Maillouski/M2-IO-Emulator-Board/fabrication/jlcpcb/m2-io-emulator-board-BOM-jlcpcb.csv

Comment | Designator | Footprint | LCSC Part #
100nF 50V X7R 0805 | C1,C2,C3,C4,C5,C6,C7,C8,C9,C10,C11,C12,C13,C14,C15,C16,C18,C20,C21,C22,C24,C27,C28,C29,C31,C33,C35,C36,C38,C43,C44,C46 | C_0805_2012Metric | C49678
10uF 25V X5R 0805 | C19,C23,C25,C26,C30,C32,C34,C37,C41,C42,C45 | C_0805_2012Metric | C15850
10nF 50V X7R 0805 | C39,C40 | C_0805_2012Metric | C1710
22uF 25V X5R 0805 | C47,C48 | C_0805_2012Metric | C45783
600R@100MHz 0805 | FB1 | L_0805_2012Metric | C1017
10029449-111RLF | J15 | HDMI_A_Amphenol_10029449-x01xLF_Horizontal | C427307
4.7k 1% 0805 | R1,R2,R3,R4,R5,R6,R7,R8,R9,R10,R11,R12,R13 | R_0805_2012Metric | C17673
1k 1% 0805 | R14,R15,R16,R17,R18,R19,R20,R21,R22,R23,R24,R25,R26,R27,R28,R29,R30,R31,R32,R33,R34,R35,R36,R37,R46,R60 | R_0805_2012Metric | C17513
10k 1% 0805 | R38,R39,R40,R41,R42,R43,R44,R45,R61,R62,R63,R64,R65 | R_0805_2012Metric | C17414
470R 1% 0805 | R47 | R_0805_2012Metric | C17710
75R 1% 0805 | R48,R49,R50 | R_0805_2012Metric | C141697
604R 1% 0805 | R51,R52,R53 | R_0805_2012Metric | C228933
200R 1% 0805 | R54,R55,R56 | R_0805_2012Metric | C17540
33R 1% 0805 | R57,R58,R59 | R_0805_2012Metric | C17634
2.2k 1% 0805 | R66,R67 | R_0805_2012Metric | C17520
74HCT86D | U2 | SOIC-14_3.9x8.7mm_P1.27mm | C6005
OPA3355EA | U3 | TSSOP-14_4.4x5mm_P0.65mm | C2652730
AT24C02C-SSHM-T | U6 | SOIC-8_3.9x4.9mm_P1.27mm | C6203
TS5V330CPWR | U7 | TSSOP-16_4.4x5mm_P0.65mm | C2652470
SN74HCT157DR | U8 | SOIC-16_3.9x9.9mm_P1.27mm | C6771
