Maillouski/M2-IO-Emulator-Board/bom/BOM-digikey.csv

Quantity | Digi-Key Part Number | Manufacturer Part Number | Manufacturer | Customer Reference
32 | 311-1140-1-ND | CC0805KRX7R9BB104 | YAGEO | C1-C16, C18, C20-C22, C24, C27-C29, C31, C33, C35, C36, C38, C43, C44, C46
11 | 1276-2891-1-ND | CL21A106KAYNNNE | Samsung Electro-Mechanics | C19, C23, C25, C26, C30, C32, C34, C37, C41, C42, C45
2 | 311-1136-1-ND | CC0805KRX7R9BB103 | YAGEO | C39, C40
2 | 1276-6780-1-ND | CL21A226MOCLRNC | Samsung Electro-Mechanics | C47, C48
1 | P19632CT-ND | EEU-FC1C101H | Panasonic Industry | C17
1 | 754-1603-ND | WP710A10GD | Kingbright | D1
1 | 490-BLM21PG601SN1DCT-ND | BLM21PG601SN1D | Murata Electronics | FB1
1 | MHC50K-ND | N2550-6002-RB | 3M | J1 (CN1)
1 | MHC26K-ND | N2526-6002-RB | 3M | J2 (CN2)
1 | 455-B10P-SHF-1AA-ND | B10P-SHF-1AA | JST Sales America | J3 (CN3)
2 | 455-B12P-SHF-1AA-ND | B12P-SHF-1AA | JST Sales America | J4 (CN5), J5 (CN6)
5 | 732-5321-ND | 61300811121 | Würth Elektronik | J6-J10
1 | 732-2670-ND | 61301011121 | Würth Elektronik | J11
1 | 732-5309-ND | 61303621121 | Würth Elektronik | J12
1 | L77HDE15SD1CH4F-ND | L77HDE15SD1CH4F | Amphenol ICC | J13
1 | 455-B5P-SHF-1AA-ND | B5P-SHF-1AA | JST Sales America | J14
1 | 609-1010-1-ND | 10029449-001RLF | Amphenol ICC (FCI) | J15
1 | CP-1435-ND | RCJ-2223 | Same Sky | J16
5 | 732-5316-ND | 61300311121 | Würth Elektronik | JP1, JP2-JP4, JP10
5 | 732-5315-ND | 61300211121 | Würth Elektronik | JP5-JP9
10 | A26228-ND | 382811-8 | TE Connectivity | SH1-SH10
13 | 311-4.70KCRCT-ND | RC0805FR-074K7L | YAGEO | R1-R13
26 | 311-1.00KCRCT-ND | RC0805FR-071KL | YAGEO | R14-R37, R46, R60
13 | 311-10.0KCRCT-ND | RC0805FR-0710KL | YAGEO | R38-R45, R61-R65
1 | RMCF0805FT470RCT-ND | RMCF0805FT470R | Stackpole Electronics Inc | R47
3 | 311-75.0CRCT-ND | RC0805FR-0775RL | YAGEO | R48-R50
3 | 311-604CRCT-ND | RC0805FR-07604RL | YAGEO | R51-R53
3 | 311-200CRCT-ND | RC0805FR-07200RL | YAGEO | R54-R56
3 | 311-33.0CRCT-ND | RC0805FR-0733RL | YAGEO | R57-R59
2 | 311-2.20KCRCT-ND | RC0805FR-072K2L | YAGEO | R66, R67
2 | 450-1650-ND | 1825910-6 | TE Connectivity | SW1, SW2
4 | 36-5002-ND | 5002 | Keystone Electronics | TP1-TP4
1 | 497-2356-5-ND | ULN2803A | STMicroelectronics | U1
1 | 1727-6360-1-ND | 74HCT86D,653 | Nexperia | U2
1 | 296-29279-1-ND | OPA3355EA/2K5 | Texas Instruments | U3
1 | AT24C02C-SSHM-TCT-ND | AT24C02C-SSHM-T | Microchip Technology | U6
1 | 296-27548-1-ND | TS5V330CPWR | Texas Instruments | U7
1 | 296-31835-1-ND | SN74HCT157DR | Texas Instruments | U8
1 | 1050-1018-ND | A000067 | Arduino | Arduino Mega 2560 Rev3 (plugs into J6-J12)
