Maillouski/M2-IO-Emulator-Board/kicad/3d/RCJ-2223_generique.step

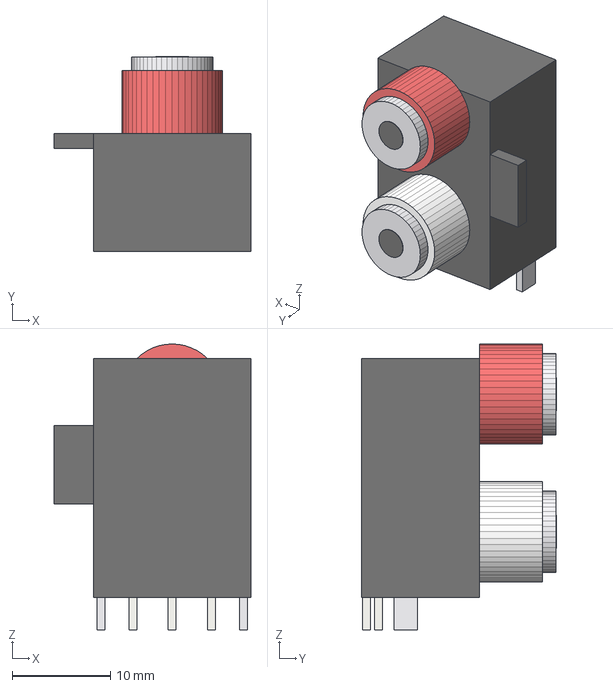
[picture p6: CAD file, 2026-10-16]
kicad/3d/RCJ-2223_generique.step
20.0 x 19.9 x 29.1 mm
