Maillouski/M2-IO-Emulator-Board/kicad/m2-io-emulator-board.kicad_pcb

## KiCad design kicad/m2-io-emulator-board.kicad_pcb (2026-10-17)

Schematic: m2-io-emulator-board.kicad_sch

Parts:
C1, C2, C3, C4, C5, C6, C7, C8, C9, C10, C11, C12, C13, C14, C15, C16, C18, C20, C21, C22, C24, C27, C28, C29, C31, C33, C35, C36, C38, C43, C44, C46: 100 nF; C_0805_2012Metric; MPN CC0805KRX7R9BB104
C17: 100 µF 16 V; CP_Radial_D6.3mm_P2.50mm; MPN EEU-FC1C101H
C19, C23, C25, C26, C30, C32, C34, C37, C41, C42, C45: 10 µF; C_0805_2012Metric; MPN CL21A106KAYNNNE
C39, C40: 10 nF; C_0805_2012Metric; MPN CC0805KRX7R9BB103
C47, C48: 22 µF; C_0805_2012Metric; MPN CL21A226MOCLRNC
D1: LED verte 3 mm; LED_D3.0mm; MPN_CMS_Flux LTST-C170KGKT
FB1: 600 Ω @ 100 MHz; L_0805_2012Metric; MPN GZ2012D601TF
J1: N2550-6002-RB; IDC-Header_2x25_P2.54mm_Vertical; MPN N2550-6002-RB
J2: N2526-6002-RB; IDC-Header_2x13_P2.54mm_Vertical; MPN N2526-6002-RB
J3: B10P-SHF-1AA; JST_NH_B10P-SHF-1AA_1x10_P2.50mm_Vertical; MPN B10P-SHF-1AA
J4, J5: B12P-SHF-1AA; JST_NH_B12P-SHF-1AA_1x12_P2.50mm_Vertical; MPN B12P-SHF-1AA
J6, J7, J8, J9, J10: 61300811121; PinHeader_1x08_P2.54mm_Vertical; MPN 61300811121
J11: 61301011121; PinHeader_1x10_P2.54mm_Vertical; MPN 61301011121
J12: Pin Header 02x18 2.54mm Vertical; PinHeader_2x18_P2.54mm_Vertical; MPN Pin Header 02x18 2.54mm Vertical
J13: VGA femelle; DSUB-15-HD_Socket_Horizontal_P2.29x2.54mm_EdgePinOffset8.35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; MPN L77HDE15SD1CH4F
J14: VIDEO; JST_NH_B5P-SHF-1AA_1x05_P2.50mm_Vertical; MPN B5P-SHF-1AA
J15: HDMI A; HDMI_A_Amphenol_10029449-x01xLF_Horizontal; MPN 10029449-111RLF
J16: XDJK-0271-1650; RCA_Dual_Stacked_RCJ-22xx_XDJK-0271-1650; MPN XDJK-0271-1650
JP1, JP2, JP3, JP4, JP10: 61300311121; PinHeader_1x03_P2.54mm_Vertical; MPN 61300311121
JP5, JP6, JP7, JP8, JP9: 61300211121; PinHeader_1x02_P2.54mm_Vertical; MPN 61300211121
R1, R2, R3, R4, R5, R6, R7, R8, R9, R10, R11, R12, R13: 4,7 kΩ; R_0805_2012Metric; MPN RC0805FR-074K7L
R14, R15, R16, R17, R18, R19, R20, R21, R22, R23, R24, R25, R26, R27, R28, R29, R30, R31, R32, R33, R34, R35, R36, R37, R46, R60: 1 kΩ; R_0805_2012Metric; MPN RC0805FR-071KL
R38, R39, R40, R41, R42, R43, R44, R45, R61, R62, R63, R64, R65: 10 kΩ; R_0805_2012Metric; MPN RC0805FR-0710KL
R47: 470 Ω; R_0805_2012Metric; MPN RMCF0805FT470R
R48, R49, R50: 75 Ω; R_0805_2012Metric; MPN RC0805FR-0775RL
R51, R52, R53: 604 Ω; R_0805_2012Metric; MPN RC0805FR-07604RL
R54, R55, R56: 200 Ω; R_0805_2012Metric; MPN RC0805FR-07200RL
R57, R58, R59: 33 Ω; R_0805_2012Metric; MPN RC0805FR-0733RL
R66, R67: 2,2 kΩ; R_0805_2012Metric; MPN RC0805FR-072K2L
SH1, SH2, SH3, SH4, SH5, SH6, SH7, SH8, SH9, SH10: 382811-8; MPN 382811-8
SW1: TEST; SW_PUSH_6mm; MPN 1825910-6
SW2: SERVICE; SW_PUSH_6mm; MPN 1825910-6
TP1, TP2, TP3, TP4: 5002; TestPoint_Keystone_5000-5004_Miniature; MPN 5002
U1: ULN2803A; DIP-18_W7.62mm; MPN ULN2803A
U2: 74HCT86; SOIC-14_3.9x8.7mm_P1.27mm; MPN 74HCT86D,653
U3: OPA3355EA; TSSOP-14_4.4x5mm_P0.65mm; MPN OPA3355EA/2K5
U4: CS5213; QFN-32-1EP_4x4mm_P0.4mm_EP2.65x2.65mm; MPN CS5213AN
U5: NX3303X; QFN-32-1EP_5x5mm_P0.5mm_EP3.1x3.1mm; MPN NX3303X; not fitted
U6: AT24C02; SOIC-8_3.9x4.9mm_P1.27mm; MPN AT24C02C-SSHM-T
U7: TS5V330; TSSOP-16_4.4x5mm_P0.65mm; MPN TS5V330CPWR
U8: 74HCT157; SOIC-16_3.9x9.9mm_P1.27mm; MPN SN74HCT157DR

Connections:
/+5V_BORNE: C17.1, C18.1, FB1.1, J1.34, J1.36, J1.38, J1.50, J3.1, J3.2, J3.3, J3.4, JP1.3, R46.1, TP2.1 (1_1), U1.10 (COMMON_FREE__WHEELING_DIODES)
/+5V_BORNE_F: C45.1, C46.1, FB1.2, JP10.3
/+5V_CONV: C25.1, C32.1, C33.1, JP10.2, U4.10 (VDD5_IN), U5.22 (VDD5)
/+5V_MEGA: C19.1, C20.1, C21.1, C22.1, C23.1, C43.1, C44.1, J2.1, J2.7, J6.5, J12.1 (Pin_2), J12.2 (Pin_1), JP1.1, JP10.1, R1.1, R2.1, R3.1, R4.1, R5.1, R6.1, R7.1, R8.1, R9.1, R10.1, R11.1, R12.1, R13.1, R38.1, R39.1, R40.1, R41.1, R42.1, R43.1, R44.1, R45.1, R61.2, TP3.1 (1_1), U2.10 (3B), U2.14 (VCC), U3.1 (ENA), U3.2 (ENB), U3.3 (ENC), U3.4 (V+), U7.16 (VCC), U8.16 (VCC)
/AMP_B: JP4.1, R59.2
/AMP_FB_B: R53.2, R56.1, U3.13 (-INC)
/AMP_FB_G: R52.2, R55.1, U3.9 (-INB)
/AMP_FB_R: R51.2, R54.1, U3.6 (-INA)
/AMP_G: JP3.1, R58.2
/AMP_OUT_B: R53.1, R59.1, U3.14 (OUTC)
/AMP_OUT_G: R52.1, R58.1, U3.8 (OUTB)
/AMP_OUT_R: R51.1, R57.1, U3.7 (OUTA)
/AMP_R: JP2.1, R57.2
/AN_ACCEL: J2.4, R28.1
/AN_BRAKE: J2.9, R29.1
/AN_STEER: J2.3, R27.1
/AUD_OUT_L: C41.2, J16.3 (X1_HAUT)
/AUD_OUT_R: C42.2, J16.2 (X2_BAS)
/CSYNC_N: R47.1, U2.8 (3Y)
/CSYNC_XOR: U2.9 (3A), U2.11 (4Y)
/CS_3V3: C26.1, C27.1, C28.1, C29.1, U4.9 (VDD33_OUT), U4.15 (VDD33), U4.16 (AUDIO_EN), U4.20 (VDD33_VDAC), U4.21 (AVD_ADAC), U4.32 (VDD33)
/CS_AUD_VREF: C30.1, C31.1, U4.23 (AUD_VREF)
/DRV_I0: J4.2, R30.1
/DRV_I1: J4.3, R31.1
/DRV_I2: J4.4, R32.1
/DRV_I3: J4.5, R33.1
/DRV_I4: J4.7, R34.1
/DRV_I5: J4.8, R35.1
/DRV_I6: J4.9, R36.1
/DRV_I7: J4.10, R37.1
/DRV_O0: J5.2, J12.4 (Pin_3)
/DRV_O1: J5.3, J12.3 (Pin_4)
/DRV_O2: J5.4, J12.6 (Pin_5)
/DRV_O3: J5.5, J12.5 (Pin_6)
/DRV_O4: J5.7, J12.8 (Pin_7)
/DRV_O5: J5.8, J12.7 (Pin_8)
/DRV_O6: J5.9, J12.10 (Pin_9)
/DRV_O7: J5.10, J12.9 (Pin_10)
/GND: C1.2, C2.2, C3.2, C4.2, C5.2, C6.2, C7.2, C8.2, C9.2, C10.2, C11.2, C12.2, C13.2, C14.2, C15.2, C16.2, C17.2, C18.2, C19.2, C20.2, C21.2, C22.2, C23.2, C24.2, C25.2, C26.2, C27.2, C28.2, C29.2, C30.2, C31.2, C32.2, C33.2, C34.2, C35.2, C36.2, C37.2, C38.2, C39.2, C40.2, C43.2, C44.2, C45.2, C46.2, C47.2, C48.2, D1.1 (K), J1.2, J1.4, J1.6, J1.10, J1.26, J2.6, J2.11, J3.7, J3.8, J3.9, J3.10, J4.12, J6.6, J6.7, J11.4, J12.35 (Pin_36), J12.36 (Pin_35), J13.5 (GND), J13.6 (R_GND), J13.7 (V_GND), J13.8 (B_GND), J13.10 (SYNC_GND), J13.SH (BLINDAGE), J14.5 (GND), J15.2 (D2S), J15.5 (D1S), J15.8 (D0S), J15.11 (CKS), J15.17 (GND), J15.SH (SHIELD), J16.1 (BARREL), JP5.2, JP6.2, JP7.2, JP8.2, JP9.2, R54.2, R55.2, R56.2, R62.2, R63.2, R64.2, R65.2, SW1.2, SW2.2, TP1.1 (1_1), U1.9 (GND), U2.7 (GND), U3.11 (V-), U4.33 (EPAD), U5.23 (GND), U5.33 (EPAD), U6.1 (A0), U6.2 (A1), U6.3 (A2), U6.4 (GND), U6.7 (WP), U7.8 (GND), U7.12 (DD), U7.13 (S2D), U7.14 (S1D), U7.15 (~EN), U8.8 (GND), U8.10 (3B), U8.11 (3A), U8.13 (4B), U8.14 (4A), U8.15 (~G)
/HDMI_5V: C24.1, J15.18 (+5V), R60.2, U6.8 (VCC)
/HDMI_CK_N: J15.12 (CK-), U4.1 (HDMI_CKN), U5.1 (RX_CK-)
/HDMI_CK_P: J15.10 (CK+), U4.2 (HDMI_CKP), U5.2 (RX_CK+)
/HDMI_D0_N: J15.9 (D0-), U4.3 (HDMI_D0N), U5.4 (RX_D0-)
/HDMI_D0_P: J15.7 (D0+), U4.4 (HDMI_D0P), U5.5 (RX_D0+)
/HDMI_D1_N: J15.6 (D1-), U4.5 (HDMI_D1N), U5.7 (RX_D1-)
/HDMI_D1_P: J15.4 (D1+), U4.6 (HDMI_D1P), U5.8 (RX_D1+)
/HDMI_D2_N: J15.3 (D2-), U4.7 (HDMI_D2N), U5.9 (RX_D2-)
/HDMI_D2_P: J15.1 (D2+), U4.8 (HDMI_D2P), U5.10 (RX_D2+)
/HDMI_HPD: J15.19 (HPD), R60.1
/HDMI_SCL: J15.15 (SCL), U6.6 (SCL)
/HDMI_SDA: J15.16 (SDA), U6.5 (SDA)
/HD_AUD_L: C39.1, C41.1, U4.24 (AUD_L), U5.17 (AOUTL)
/HD_AUD_R: C40.1, C42.1, U4.22 (AUD_R), U5.18 (AOUTR)
/HD_B: U4.17 (VGA_B), U5.12 (B), U7.11 (S1C)
/HD_G: U4.18 (VGA_G), U5.13 (G), U7.5 (S1B)
/HD_HS: R62.1, U4.12 (VGA_HS), U5.27 (HSYNC), U8.2 (1A)
/HD_R: U4.19 (VGA_R), U5.14 (R), U7.2 (S1A)
/HD_VS: R63.1, U4.11 (VGA_VS), U5.24 (VSYNC), U8.5 (2A)
/HS_AVG: C47.1, R66.2, U2.2 (1B)
/HS_NORM: U2.3 (1Y), U2.13 (4B)
/IN_COIN1: C1.1, J1.1, R1.2, R14.1
/IN_COIN2: C2.1, J1.3, R2.2, R15.1
/IN_SERVICE: C4.1, J1.7, R4.2, R17.1, SW2.1
/IN_SH13: C10.1, J1.25, R10.2, R23.1
/IN_SH24: C11.1, J1.27, R11.2, R24.1
/IN_SH1234: C12.1, J1.29, R12.2, R25.1
/IN_SH_NU: C13.1, J1.31, R13.2, R26.1
/IN_START: C5.1, J1.9, R5.2, R18.1
/IN_TEST: C3.1, J1.5, R3.2, R16.1, SW1.1
/IN_VR1: C6.1, J1.11, R6.2, R19.1
/IN_VR2: C7.1, J1.13, R7.2, R20.1
/IN_VR3: C8.1, J1.15, R8.2, R21.1
/IN_VR4: C9.1, J1.17, R9.2, R22.1
/J13_B: J13.3 (B), U7.10 (S2C)
/J13_G: J13.2 (V), U7.6 (S2B)
/J13_HS: J13.13 (HSYNC), R64.1, U8.3 (1B)
/J13_R: J13.1 (R), U7.3 (S2A)
/J13_VS: J13.14 (VSYNC), R65.1, U8.6 (2B)
/LED_BORNE_A: D1.2 (A), R46.2
/MEGA_A0_STEER: C14.1, J7.1, R27.2
/MEGA_A1_ACCEL: C15.1, J7.2, R28.2
/MEGA_A2_BRAKE: C16.1, J7.3, R29.2
/MEGA_A8_METER1: J8.1, U1.1 (IN_1)
/MEGA_A9_METER2: J8.2, U1.2 (IN_2)
/MEGA_A10_LAMP_START: J8.3, U1.3 (IN_3)
/MEGA_A11_LAMP_VR1: J8.4, U1.4 (IN_4)
/MEGA_A12_LAMP_VR2: J8.5, U1.5 (IN_5)
/MEGA_A13_LAMP_VR3: J8.6, U1.6 (IN_6)
/MEGA_A14_LAMP_VR4: J8.7, U1.7 (IN_7)
/MEGA_A15_LEADER: J8.8, U1.8 (IN_8)
/MEGA_D10_DRV_I4: J11.8, R34.2, R42.2
/MEGA_D11_DRV_I5: J11.7, R35.2, R43.2
/MEGA_D12_DRV_I6: J11.6, R36.2, R44.2
/MEGA_D13_DRV_I7: J11.5, R37.2, R45.2
/MEGA_D30_SH_NU: J12.12 (Pin_11), R26.2
/MEGA_D31_SH1234: J12.11 (Pin_12), R25.2
/MEGA_D32_SH24: J12.14 (Pin_13), R24.2
/MEGA_D33_SH13: J12.13 (Pin_14), R23.2
/MEGA_D36_ECRAN: J12.18 (Pin_17), JP8.1
/MEGA_D37_VR4: J12.17 (Pin_18), R22.2
/MEGA_D42_VR3: J12.24 (Pin_23), R21.2
/MEGA_D43_VR2: J12.23 (Pin_24), R20.2
/MEGA_D44_VR1: J12.26 (Pin_25), R19.2
/MEGA_D45_START: J12.25 (Pin_26), R18.2
/MEGA_D46_SERVICE: J12.28 (Pin_27), R17.2
/MEGA_D47_TEST: J12.27 (Pin_28), R16.2
/MEGA_D48_COIN2: J12.30 (Pin_29), R15.2
/MEGA_D49_COIN1: J12.29 (Pin_30), R14.2
/MEGA_D50_DRV_I3: J12.32 (Pin_31), R33.2, R41.2
/MEGA_D51_DRV_I2: J12.31 (Pin_32), R32.2, R40.2
/MEGA_D52_DRV_I1: J12.34 (Pin_33), R31.2, R39.2
/MEGA_D53_DRV_I0: J12.33 (Pin_34), R30.2, R38.2
/NX_1V2: C37.1, C38.1, U5.3 (VDD12), U5.20 (LDO1V2), U5.31 (DVDD12)
/NX_3V3: C34.1, C35.1, C36.1, U5.6 (VDD33), U5.11 (VDD33), U5.15 (VDD33), U5.19 (VDD33), U5.21 (LDO3V3), U5.32 (VDD33)
/OUT_LAMP_START: J1.37, U1.16 (OUT_3)
/OUT_LAMP_VR1: J1.39, U1.15 (OUT_4)
/OUT_LAMP_VR2: J1.41, U1.14 (OUT_5)
/OUT_LAMP_VR3: J1.43, U1.13 (OUT_6)
/OUT_LAMP_VR4: J1.45, U1.12 (OUT_7)
/OUT_LEADER: J1.47, U1.11 (OUT_8)
/OUT_METER1: J1.33, U1.18 (OUT_1)
/OUT_METER2: J1.35, U1.17 (OUT_2)
/SRC_SEL: JP9.1, R61.1, U7.1 (IN), U8.1 (~A/B)
/TERM_B: JP7.1, R50.2
/TERM_G: JP6.1, R49.2
/TERM_R: JP5.1, R48.2
/VCC_DRIVE: J1.42, J1.44, JP1.2, TP4.1 (1_1)
/VGA_B: JP4.3, R50.1, U3.12 (+INC), U7.9 (DC)
/VGA_G: JP3.3, R49.1, U3.10 (+INB), U7.7 (DB)
/VGA_HS: R66.1, U2.1 (1A), U8.4 (1Y)
/VGA_R: JP2.3, R48.1, U3.5 (+INA), U7.4 (DA)
/VGA_VS: R67.1, U2.5 (2B), U8.7 (2Y)
/VIDEO_SYNC: J14.4 (SYNC), R47.2
/VID_B: J14.3 (B), JP4.2
/VID_G: J14.2 (V), JP3.2
/VID_R: J14.1 (R), JP2.2
/VS_AVG: C48.1, R67.2, U2.4 (2A)
/VS_NORM: U2.6 (2Y), U2.12 (4A)

Notes on the sheet:
Boutons de la carte (2026-10-09) : SW1 = TEST, SW2 = SERVICE (comme SW6 et SW7 de la carte E/S d'origine), vers la masse ; anti-rebond par le conditionneur de l'entrée (4,7 kΩ / 100 nF / 1 kΩ).
Ampli vidéo R/V/B (2026-10-12) : U3 OPA3355, gain 4,02 (RF 604 Ω / RG 200 Ω), RS 33 Ω en sortie ; +5V_MEGA. JP2-JP4 (R, V, B) : 1-2 = AMP, 2-3 = DIR (VGA direct vers J14). JP5-JP7 : terminaison 75 Ω (R48-R50) en service si posé. Adaptateur HDMI → VGA (0,7 V) : AMP + JP5-JP7 posés. Source déjà au ni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
Choix de l'écran de l'hôte (2026-10-13, carte V2) : JP8 relie D36 du Mega (bit 1 de IN1, rappel interne) à la masse. Cavalier posé = HDMI vers le tube (24 kHz, 4:3) ; retiré = LVDS (16:9). Lu par l'hôte au démarrage, par le Mega.
V3 (2026-10-15, non publiée) : HDMI → VGA intégré. J15 HDMI → U4 CS5213 OU U5 NX3303X (jamais les deux) → U7/U8. JP9 SOURCE : posé = HDMI, retiré = VGA J13 (comme la V2). Sorties = VGA_R/G/B/HS/VS (U2, U3, JP2-JP4 inchangés). JP10 alim de la puce : 1-2 = +5V_MEGA, 2-3 = +5V_BORNE filtré (FB1). U6 E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
Bloc vidéo tube (2026-10-07) : VGA de l'adaptateur HDMI → VGA → synchro composite (74HCT86) → fiche vidéo du faisceau (J14). J14 « VIDEO » : ordre de la NH5P de la carte filtre 839-0683 (1 R, 2 V, 3 B, 4 SYNC, 5 GND). R48-R50 (75 Ω) posées depuis le 2026-10-12, en service par JP5-JP7 ; J14 R/V/B pa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
V3 (2026-10-16) : synchro indépendante de la polarité (T. Engdahl). U2 portes 1-2 : chaque synchro XOR sa moyenne (2,2 kΩ / 22 µF) → HS_NORM, VS_NORM en impulsions positives → porte 4 → porte 3 (inversion) : CSYNC négative quelles que soient les polarités H/V.

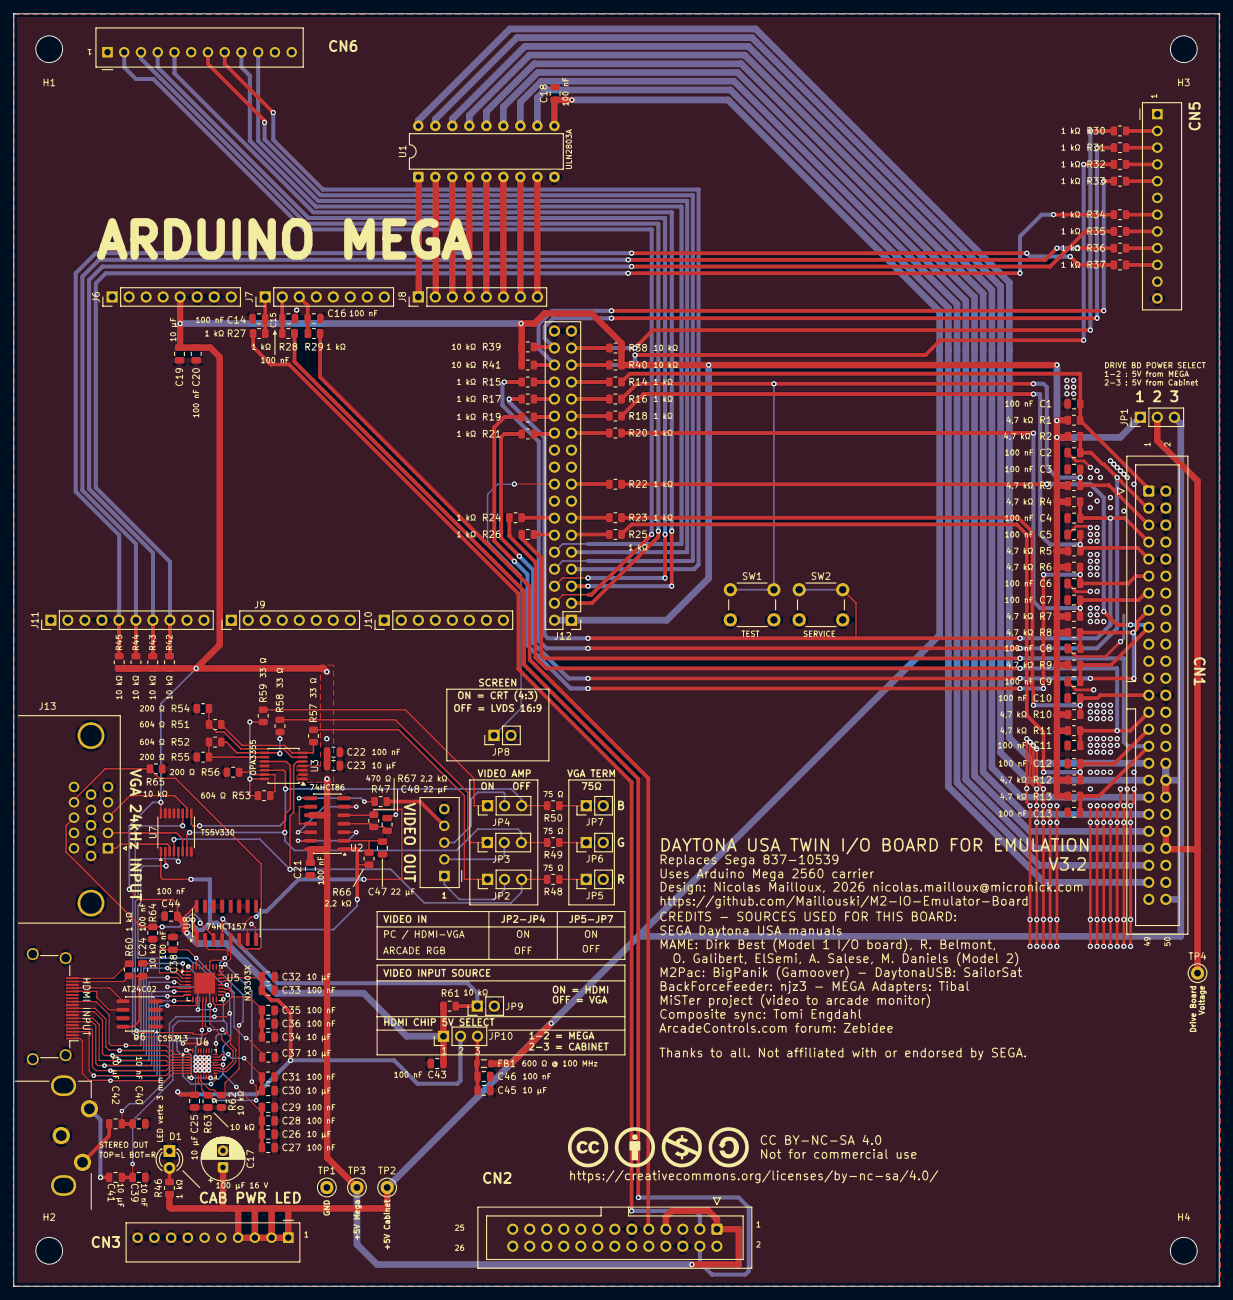
[picture p8: board m2-io-emulator-board.kicad_pcb from above]

Board: 2 copper layers, 180.0 x 190.0 mm, 163 parts (0 on the bottom side), 138 nets.

Other parts of the board:
H1, H2, H3, H4: MountingHole_4.0mm
LOGO1: CC_BY-NC-SA_4.0
MEGA1: Arduino Mega 2560 (à l'envers); Arduino_Mega2560_3D
