Maillouski/M2-IO-Emulator-Board/(commit log)

2026-10-12 M2 IO Emulator Board: KiCad 10 project, Gerbers, full DigiKey BOM
    Replacement for the Sega 837-10539 I/O board of the Daytona USA twin
    cabinet, built around an Arduino Mega 2560. Prototype, not yet built.
    [BOM-digikey.csv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]
2026-10-12 French translation (README, BOM, 3D models); silkscreen URL now points to this repository
    Only F_Silkscreen changed in the Gerbers (checked file by file, dates ignored).
    [m2-io-emulator-board-B_Cu.gbr, m2-io-emulator-board-B_Mask.gbr, m2-io-emulator-board-B_Paste.gbr, m2-io-emulator-board-B_Silkscreen.gbr, m2-io-emulator-board-Edge_Cuts.gbr, m2-io-emulator-board-F_Cu.gbr, m2-io-emulator-board-F_Mask.gbr, m2-io-emulator-board-F_Paste.gbr]
2026-10-12 3D models for the JST NH headers (CN3, CN5, CN6, J14), made for this project; renders updated
    Simplified base + pins from JST NH datasheet and DigiKey dimensions, in the footprint frame
    (no offset/rotation). Only the 3D model blocks changed in the PCB: Gerbers unchanged.
    [m2-io-emulator-board.kicad_pcb]
2026-10-12 JLCPCB files for SMD assembly (BOM with LCSC numbers, CPL with rotation corrections) and ordering guide (EN/FR); silkscreen R/G/B labels realigned, Gerbers regenerated
    [m2-io-emulator-board-BOM-jlcpcb.csv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]
2026-10-12 README (EN/FR): open points updated - CN3/CN5 pitch measured at 2.50 mm, only J14 left; CN1 plug fit checked
2026-10-12 U1 (ULN2803A) soldered directly: DIP-18 socket SK1 removed from schematic, PCB and BOM; Gerbers (silkscreen only), schematic PDF and renders updated
    [BOM-digikey.csv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]
2026-10-13 README: J14 pin order checked on a Daytona USA twin cabinet (1 R, 2 G, 3 B, 4 sync, 5 GND)
2026-10-13 README: video plug pitch measured (10.00 mm pin 1 to 5): all NH footprints confirmed at 2.5 mm
2026-10-13 V2: screen jumper JP8 (Mega D36 to ground: ON = CRT 4:3, OFF = LVDS 16:9), framed silkscreen; Gerbers, drill files, schematic PDF, renders and BOM (EN/FR) updated
    V1, the board ordered from JLCPCB on 2026-10-13, is tagged v1. JLCPCB BOM and CPL are unchanged (JP8 is through-hole).
    [BOM-digikey.csv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]
2026-10-14 Mega firmware, test console and host protocol guide (EN/FR): how to drive the board from your own computer or emulator build
2026-10-14 README (EN/FR): open points trimmed (NH pitch, J14 pin order and video level removed)
2026-10-14 Docs (EN/FR): state only, no test history; host guide section 8 becomes precautions with a real drive board
2026-10-16 V3: HDMI input with on-board HDMI to VGA converter (CS5213), source jumper JP9, converter power jumper JP10, stereo RCA output, optional EDID EEPROM (DNP); Gerbers, drill files, schematic PDF, render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
    [BOM-digikey.csv, RCJ-2223_generique.step, m2-io-emulator-board-BOM-jlcpcb.csv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]
2026-10-16 V3: polarity-independent composite sync (Tomi Engdahl's circuit: R66/R67 + C47/C48, all 4 gates of U2), EDID EEPROM U6 and C24 now fitted, "V3" and "24kHz" on the silkscreen; Gerbers, drill files, sc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
    [BOM-digikey.csv, m2-io-emulator-board-BOM-jlcpcb.csv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]
2026-10-16 Silkscreen credits: Tomi Engdahl (composite sync) and Zebidee (ArcadeControls.com forum); README credits (EN/FR); 3D model of the RCA jack J16 now 12 mm deep (body + rear cover, per datasheet), no st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
    [RCJ-2223_generique.step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]
2026-10-16 BOM: in-stock replacements for the 10 µF and 22 µF capacitors, C17, R47 and J15 (DigiKey, checked 2026-10-16); JST NH headers from LCSC; schematic MPN fields updated
    [BOM-digikey.csv, m2-io-emulator-board.kicad_pcb, m2-io-emulator-board.kicad_sch]
2026-10-17 Docs: the via option for U4's exposed pad is "Epoxy Filled & Capped" (JLCPCB's "Plugged" does not cover vias in pads); offered for 2-layer boards on 2026-10-16
2026-10-17 V3.2: J16 footprint fits the Same Sky RCJ-2223 or the Lian Xin XDJK-0271-1650 (LCSC C7527522, in stock at JLCPCB); top jack = left, bottom = right; J16 moved 2.25 mm; U4 exposed-pad vias filled and c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
    [m2-io-emulator-board-B_Cu.gbr, m2-io-emulator-board-B_Mask.gbr, m2-io-emulator-board-B_Paste.gbr, m2-io-emulator-board-B_Silkscreen.gbr, m2-io-emulator-board-Edge_Cuts.gbr, m2-io-emulator-board-F_Cu.gbr, m2-io-emulator-board-F_Mask.gbr, m2-io-emulator-board-F_Paste.gbr]
