Maillouski/M2-IO-Emulator-Board/(notices)

Notices in the files:
parts and their libraries:
Pictogrammes Creative Commons CC BY NC SA (icônes officielles, mirrors.creativecommons.org/presskit/icons) et mention de la licence CC BY-NC-SA 4.0, sérigraphie
https://creativecommons.org/licenses/by-nc-sa/4.0
